jasonacox/UltrasonicDistanceDisplay/images/7segmentLED.png

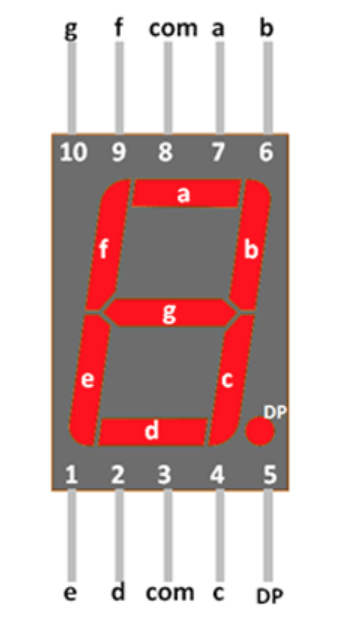
images/7segmentLED.png
