jasonacox/UltrasonicDistanceDisplay/images/74HC595.jpg

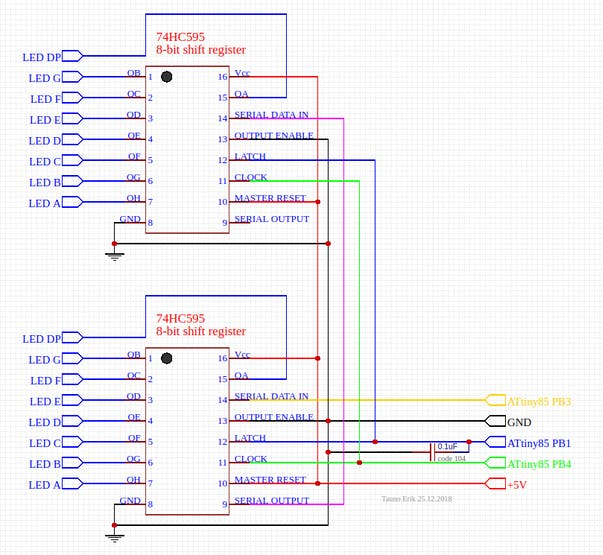
images/74HC595.jpg
