jasonacox/UltrasonicDistanceDisplay/kicad/ATTiny85 Distance Sensor.sch

## KiCad design kicad/ATTiny85 Distance Sensor.sch (2020-05-03)

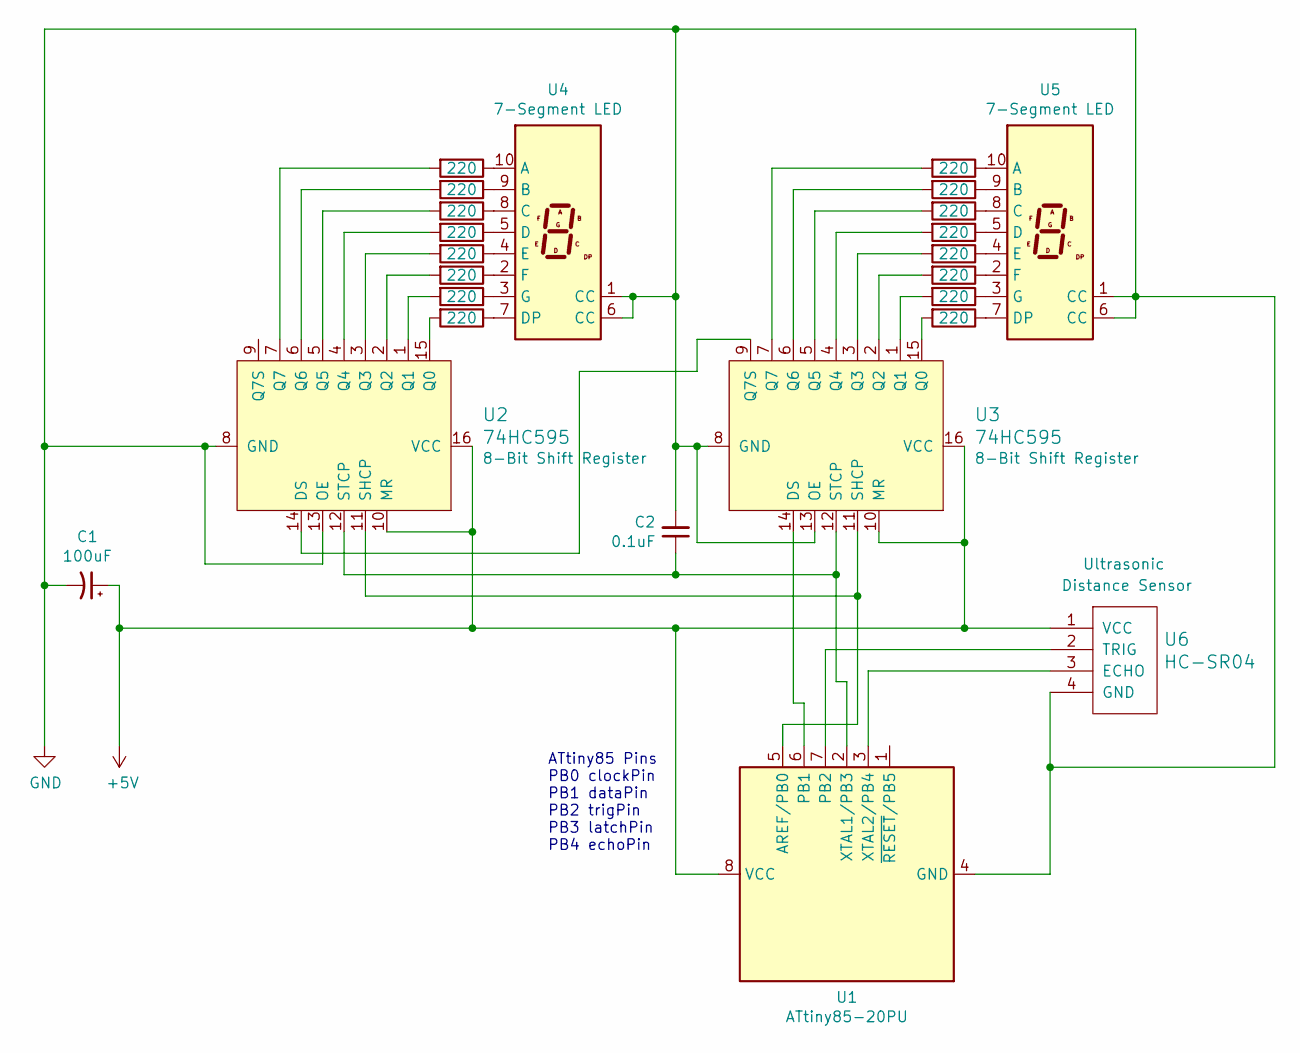
[picture p5: schematic ATTiny85 Distance Sensor.sch]

Parts:
C1: 100uF
C2: 0.1uF
U1: ATtiny85-20PU; DIP-8_W7.62mm
U2, U3: 74HC595; SOIC-16_W3.90mm; MPN 74HC595D,118; Digi-Key_PN 1727-2821-1-ND
U4, U5: 7-Segment LED; HDSP-A151
U6: HC-SR04

Connections:
+5V: C1.1, U1.8 (VCC), U2.10 (MR), U2.16 (VCC), U3.10 (MR), U3.16 (VCC), U6.1 (VCC)
GND: C1.2, C2.2, U1.4 (GND), U2.8 (GND), U2.13 (OE), U3.8 (GND), U3.13 (OE), U4.1 (CC), U4.6 (CC), U5.1 (CC), U5.6 (CC), U6.4 (GND)
unnamed: C2.1, U1.2 (XTAL1/PB3), U2.12 (STCP), U3.12 (STCP)
unnamed: U1.3 (XTAL2/PB4), U6.3 (ECHO)
unnamed: U1.5 (AREF/PB0), U2.11 (SHCP), U3.11 (SHCP)
unnamed: U1.6 (PB1), U3.14 (DS)
unnamed: U1.7 (PB2), U6.2 (TRIG)
unnamed: U2.14 (DS), U3.9 (Q7S)

Notes on the sheet:
ATtiny85 Pins PB0 clockPin PB1 dataPin PB2 trigPin PB3 latchPin PB4 echoPin
