jasonacox/UltrasonicDistanceDisplay/(commit log)

2020-05-03 Added schematic
    [ATTiny85 Distance Sensor.sch]
2020-05-03 Updated List of Materials
2020-05-03 Added sleep logic to code and prototype
2020-05-03 Updated prototype
